kholia/PicoRX/PCB/Easy-uSDX-v4/README.txt

https://www.w0qe.com/Projects/rf_clipper_2016.html
