kholia/PicoRX/PCB/Easy-uSDX-v4/info/README.txt

https://www.james.ahlstrom.name/quisk/docs.html

https://github.com/pothosware/SoapyAudio (Gqrx supports IQ sound card input
using this)

https://github.com/kaefe64/Arduino_uSDX_Pico_FFT_Proj/issues/4

https://github.com/ArjanteMarvelde/uSDR-pico - Wait for Arjan to release v4!

Select filters so to keep a narrow BW (6 kHz maximum).

https://martein.home.xs4all.nl/pa3ake/hmode/img/IF_detector_assy.jpg

Sound Blaster PLAY! 3 USB - has stereo input!
