kholia/PicoRX/PCB/Easy-uSDX-v2/info/QMX+.pdf

QMX+ PCB Rev 1 Schematics

Note, component numbering indicates the page number of the schematics; e.g. all components numbered 1xx are on page 1 etc. R106, for example, is on schematics page 1.

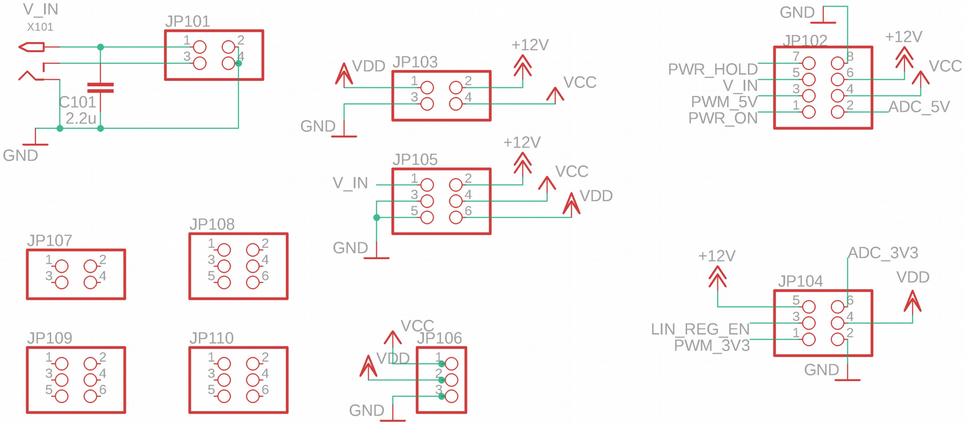
[picture p1: figure]

0: Connectors

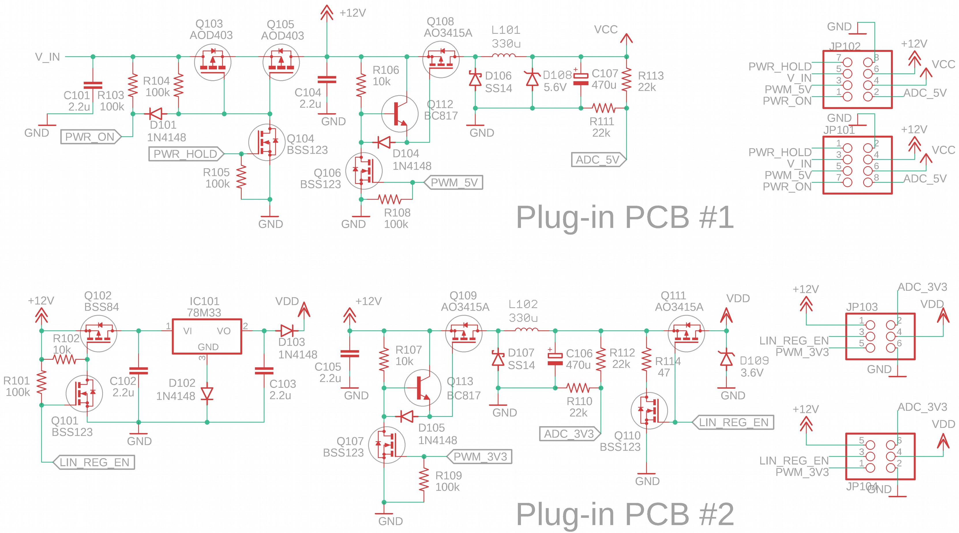
[picture p2: page 2]

1: SMS power supplies

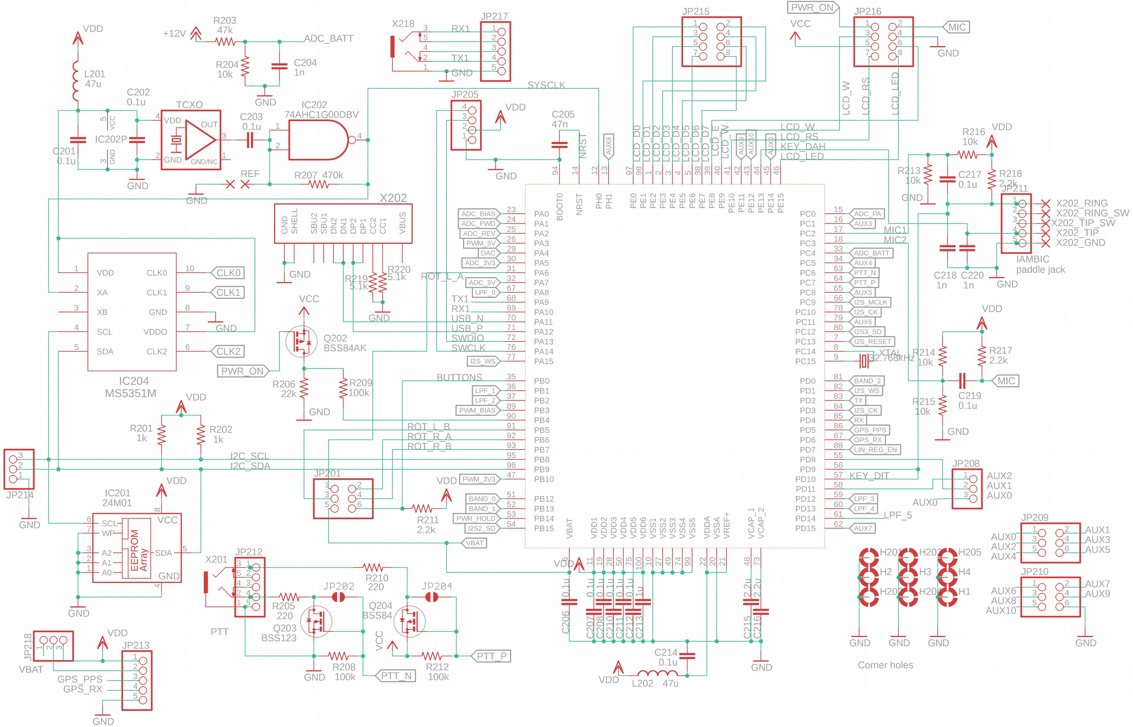
[picture p3: page 3]

2: Microcontroller and digital sections

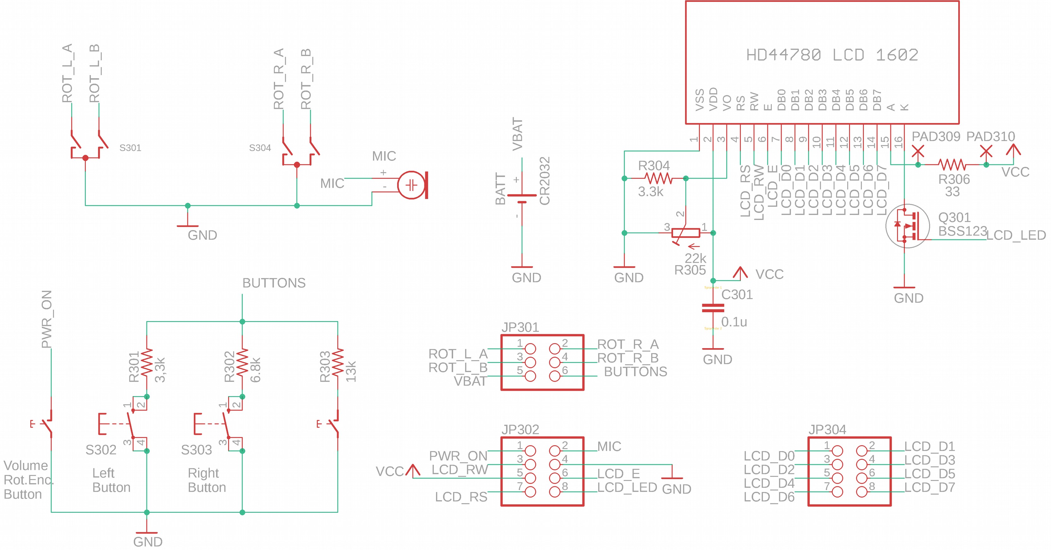
[picture p4: page 4]

3: Front panel board

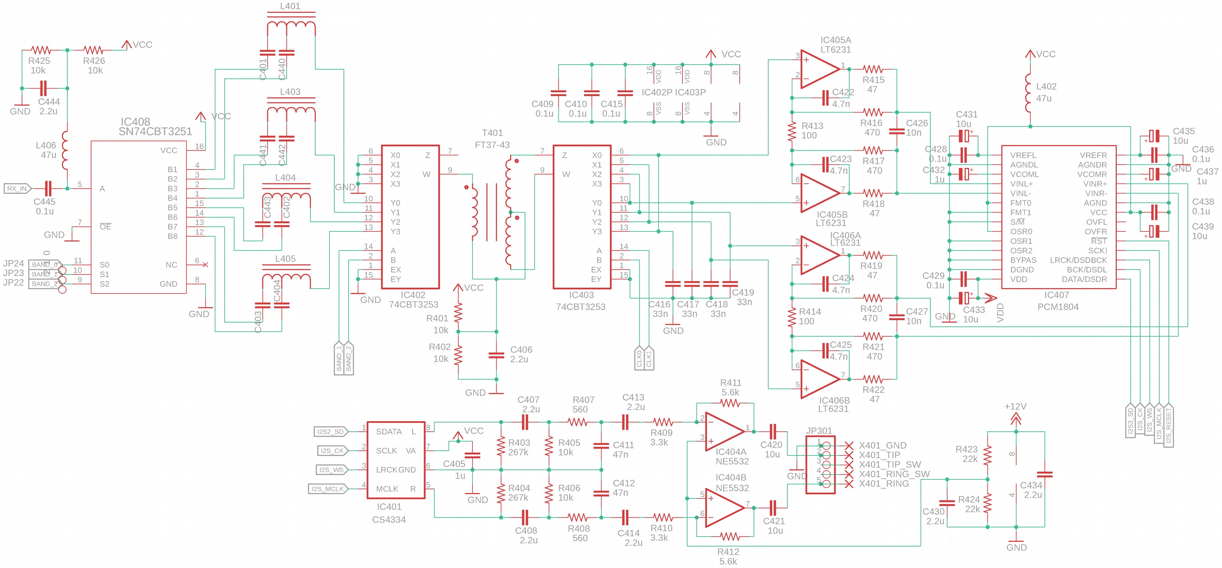
[picture p5: figure]

4: Receiver

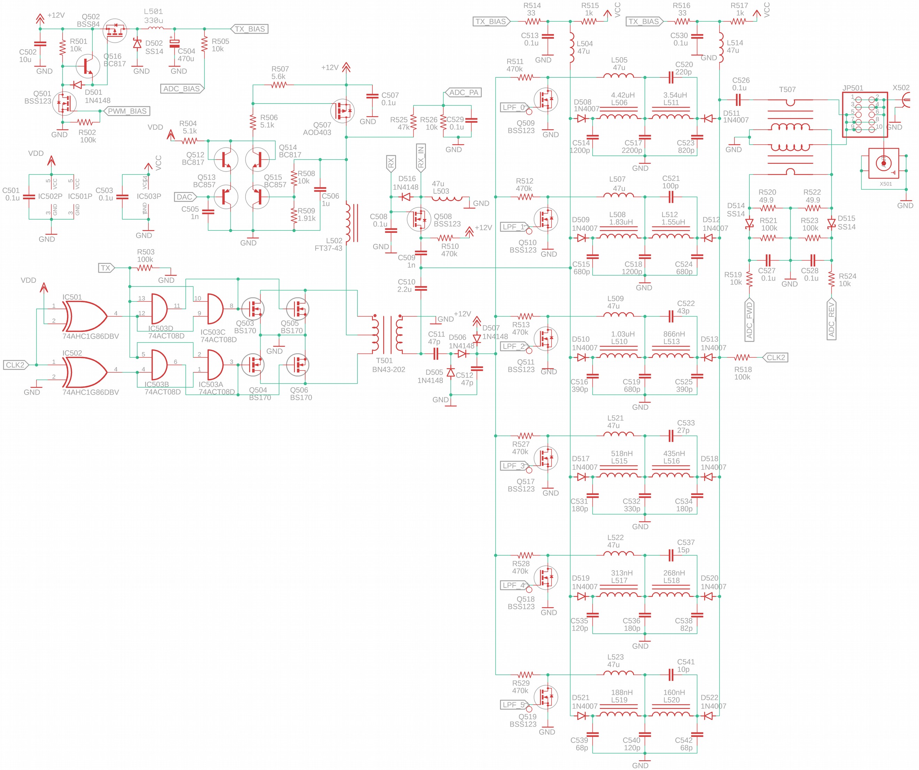
[picture p6: page 6]

5: Transmitter
