kholia/PicoRX/PCB/Easy-uSDX-v2/models/pj-307.step

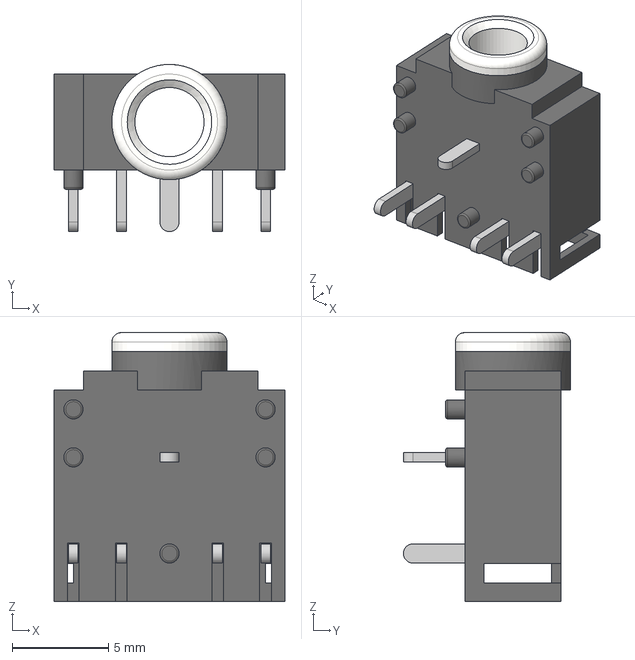
[picture p41: CAD file, 2024-11-27, an earlier design]
PCB/Easy-uSDX-v2/models/pj-307.step
12.0 x 8.70 x 14.0 mm
