kholia/PicoRX/PCB/Easy-uSDX-v4/models/Adafruit Si5351A.step

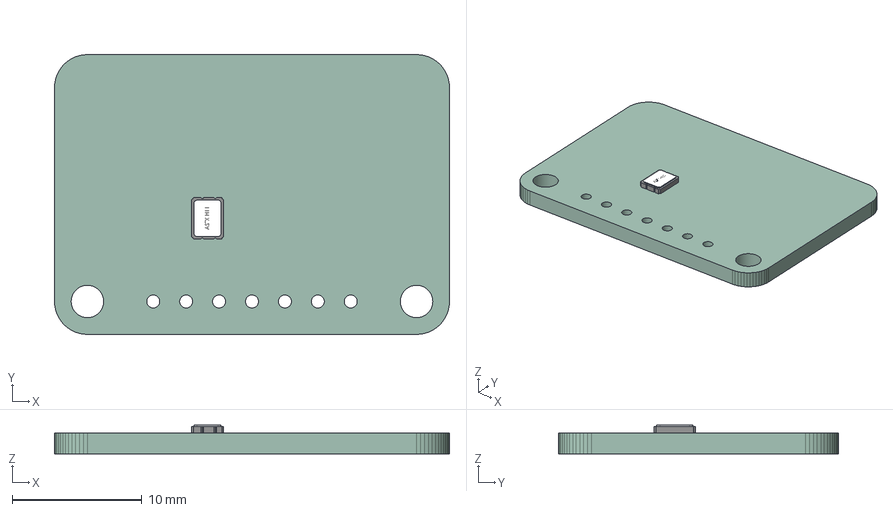
[picture p42: CAD file, 2024-11-27, an earlier design]
PCB/Easy-uSDX-v4/models/Adafruit Si5351A.step
30.5 x 21.6 x 2.20 mm
PCB
