kholia/PicoRX/PCB/Easy-uSDX-v2/models/CUI_DEVICES_SJ1-3523N.step

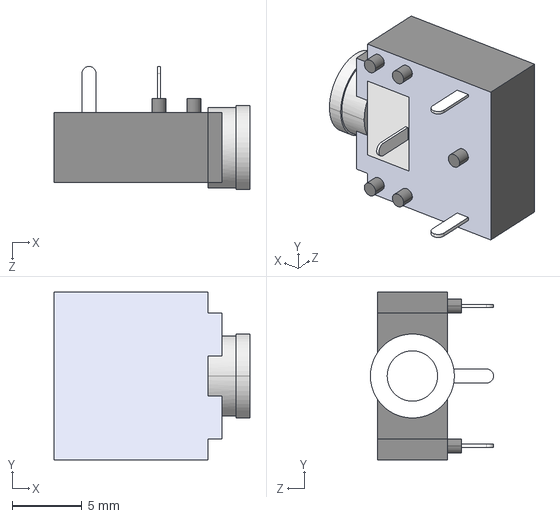
[picture p43: CAD file, 2024-11-27, an earlier design]
PCB/Easy-uSDX-v2/models/CUI_DEVICES_SJ1-3523N.step
14.0 x 12.0 x 8.80 mm
