kholia/PicoRX/PCB/Easy-uSDX-v3/models/SO-8_S_LIT.step

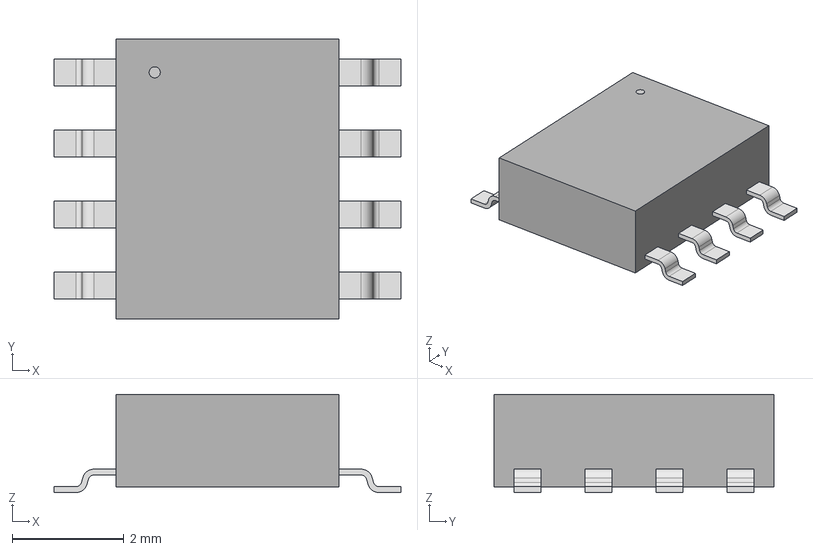
[picture p44: CAD file, 2024-11-27, an earlier design]
PCB/Easy-uSDX-v3/models/SO-8_S_LIT.step
6.20 x 5.00 x 1.75 mm
