kholia/PicoRX/PCB/Easy-uSDX-v4/models/22-23-2021.stp

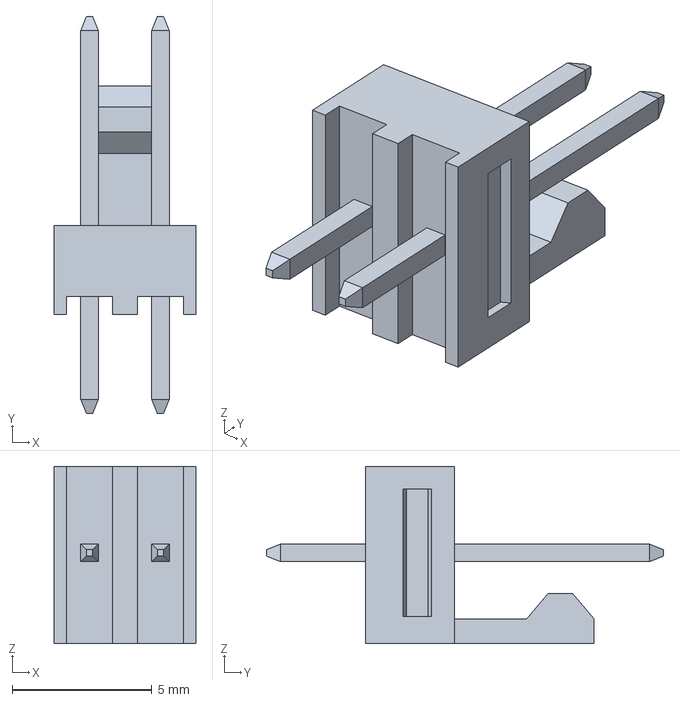
[picture p45: CAD file, 2024-11-27, an earlier design]
PCB/Easy-uSDX-v4/models/22-23-2021.stp
5.08 x 14.2 x 6.35 mm
