kholia/PicoRX/PCB/Easy-uSDX-v3/models/smd1812.stp

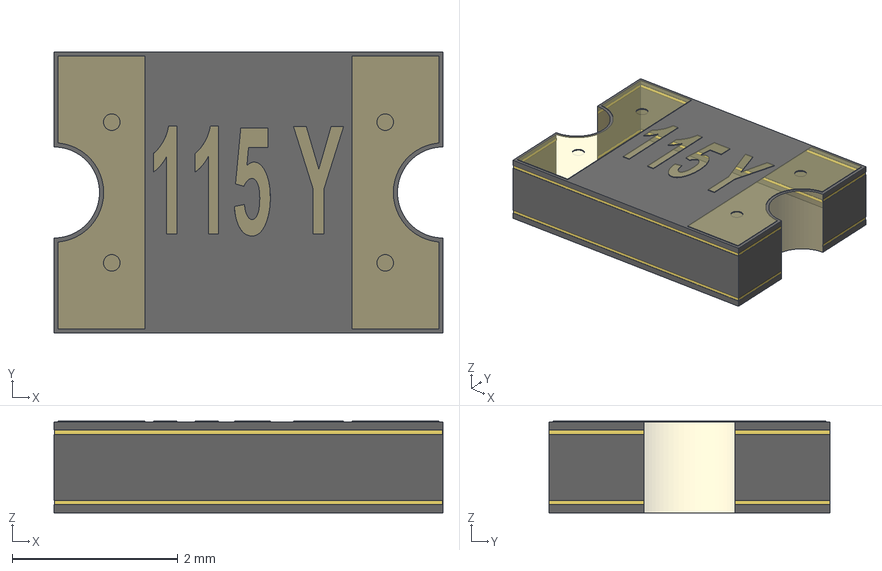
[picture p46: CAD file, 2024-11-27, an earlier design]
PCB/Easy-uSDX-v3/models/smd1812.stp
4.70 x 3.40 x 1.11 mm
