kholia/PicoRX/PCB/Easy-uSDX-v2/models/901-144.stp

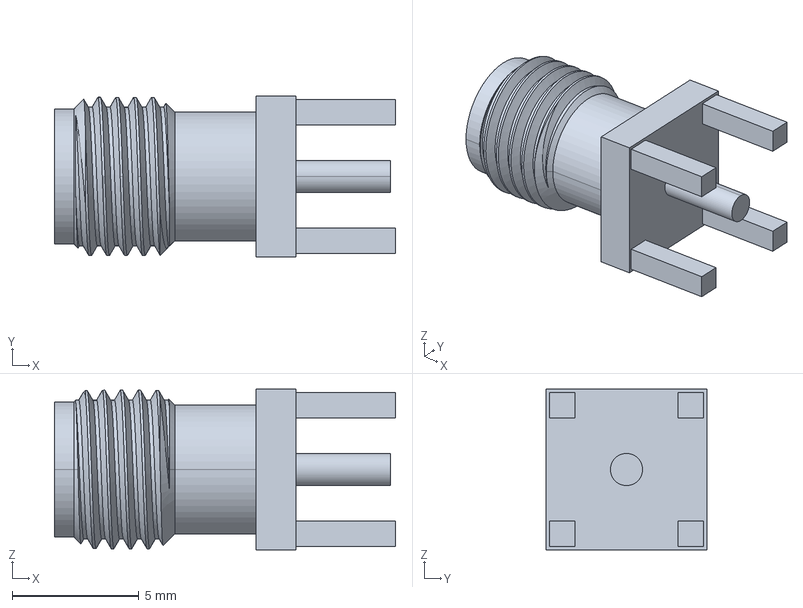
[picture p47: CAD file, 2024-11-27, an earlier design]
PCB/Easy-uSDX-v2/models/901-144.stp
13.5 x 6.35 x 6.35 mm
