kholia/PicoRX/(list of files, cad)

Other CAD files:
PCB/Easy-uSDX-v3/models/Adafruit Si5351A Plain.step
PCB/Easy-uSDX-v2/models/Adafruit Si5351A Plain.step
PCB/Easy-uSDX-v4/models/Adafruit Si5351A Plain.step
