kholia/PicoRX/PCB/Easy-uSDX-v2/SDR-Board.pdf

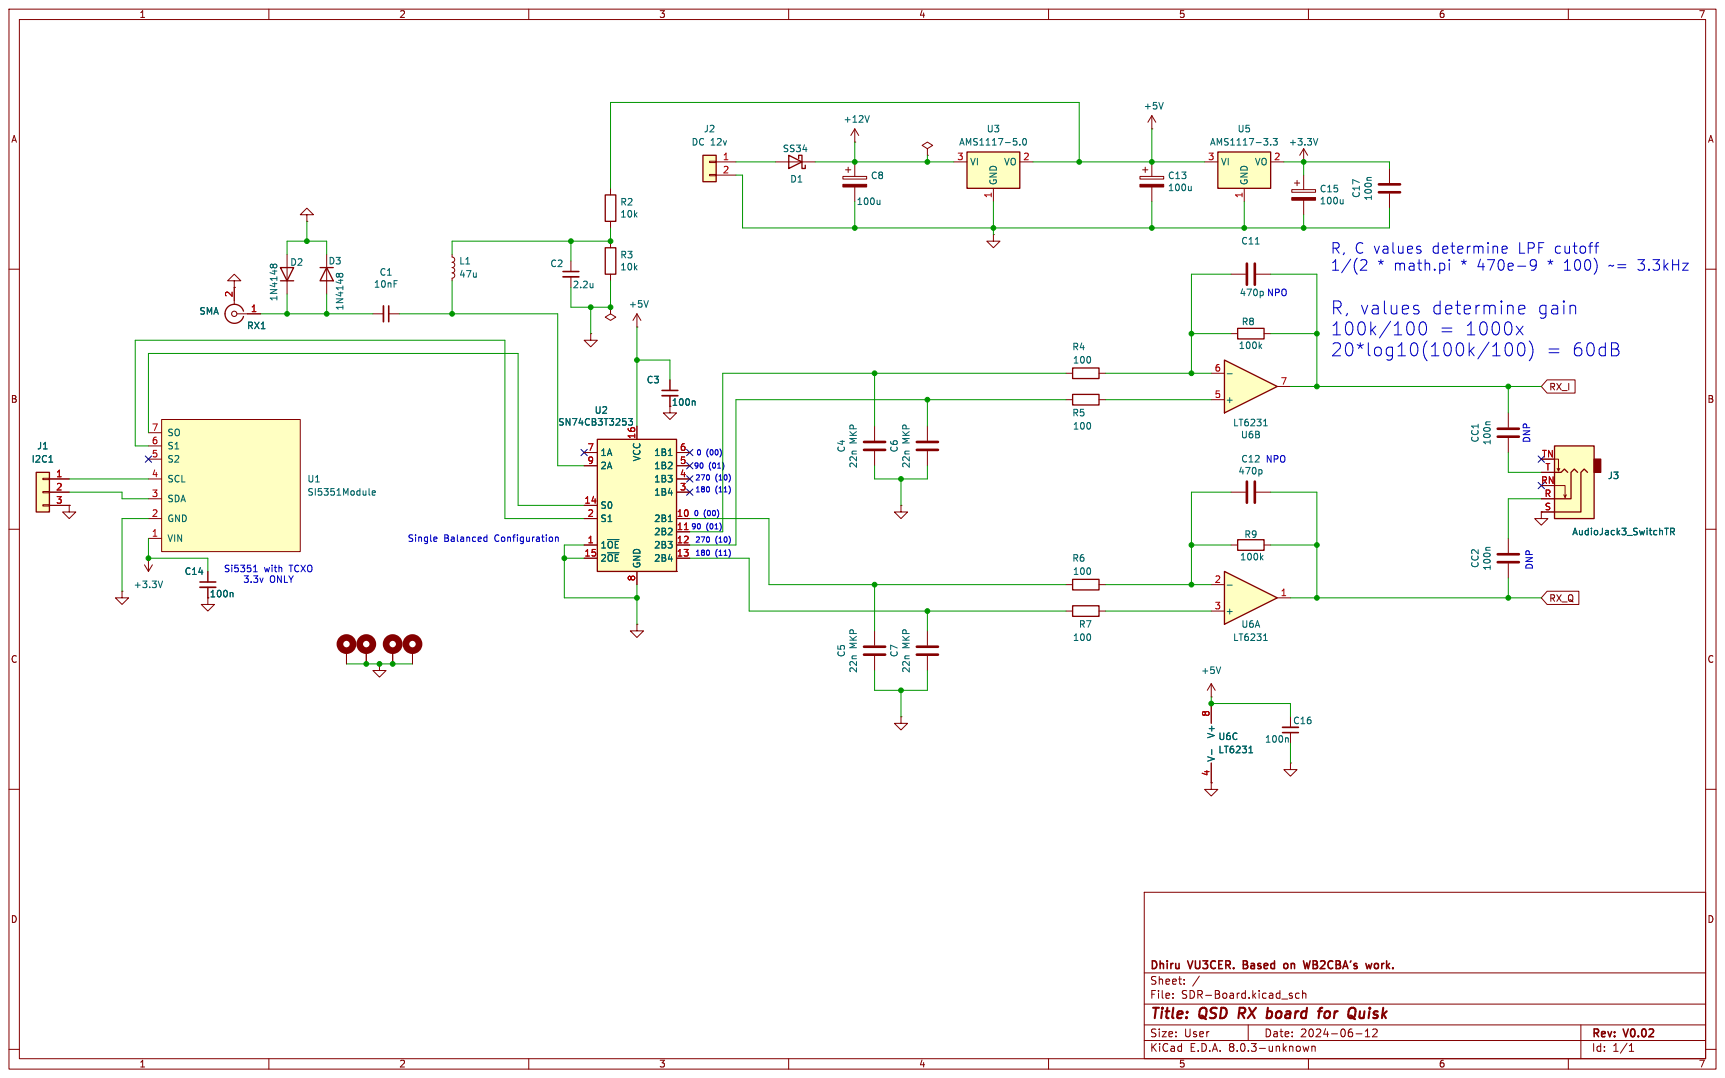
[picture p48: page 1]

Id: 1/1 Title: QSD RX board for Quisk
