kholia/PicoRX/PCB/Easy-uSDX-v3/SDR-Board.pdf

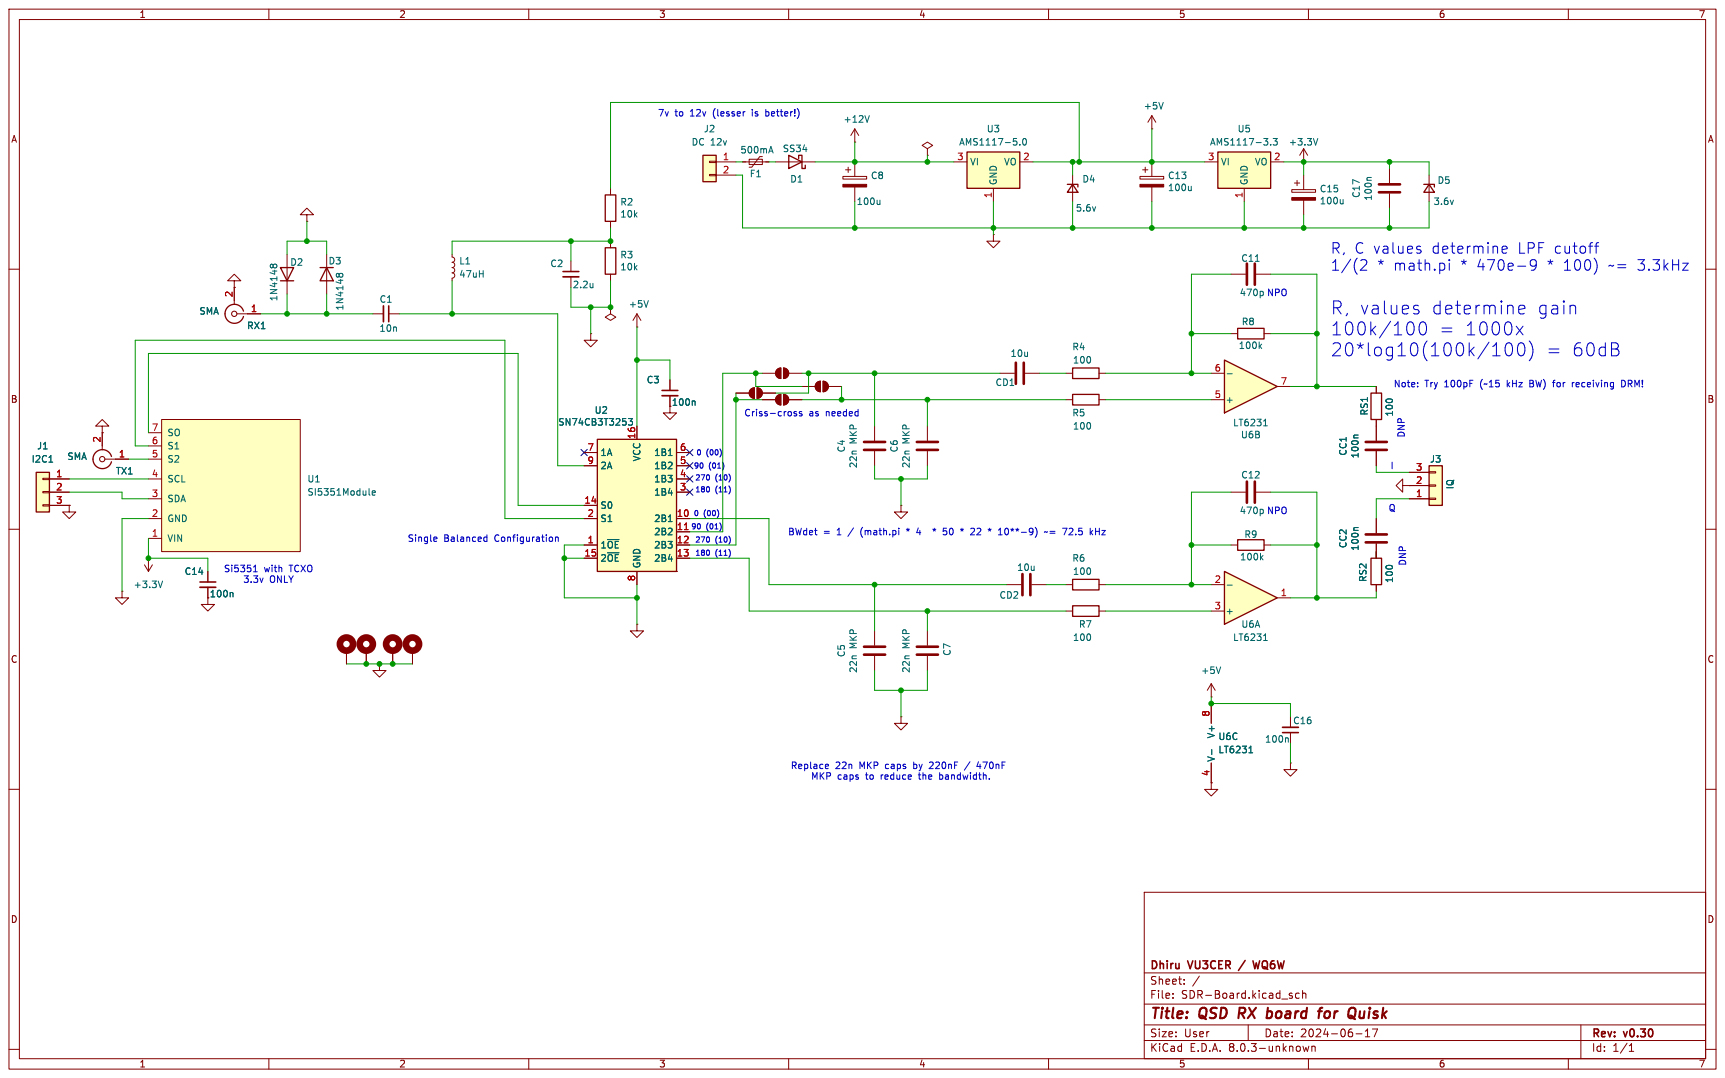
[picture p49: page 1]

Replace 22n MKP caps by 220nF / 470nF MKP caps to reduce the bandwidth. 0 (00) 270 (10) 180 (11) C3

File: SDR-Board.kicad_sch Sheet: / Dhiru VU3CER / WQ6W

Id: 1/1 Title: QSD RX board for Quisk
