kholia/PicoRX/PCB/Easy-uSDX-v3/info/truSDX_Main_1_2.pdf

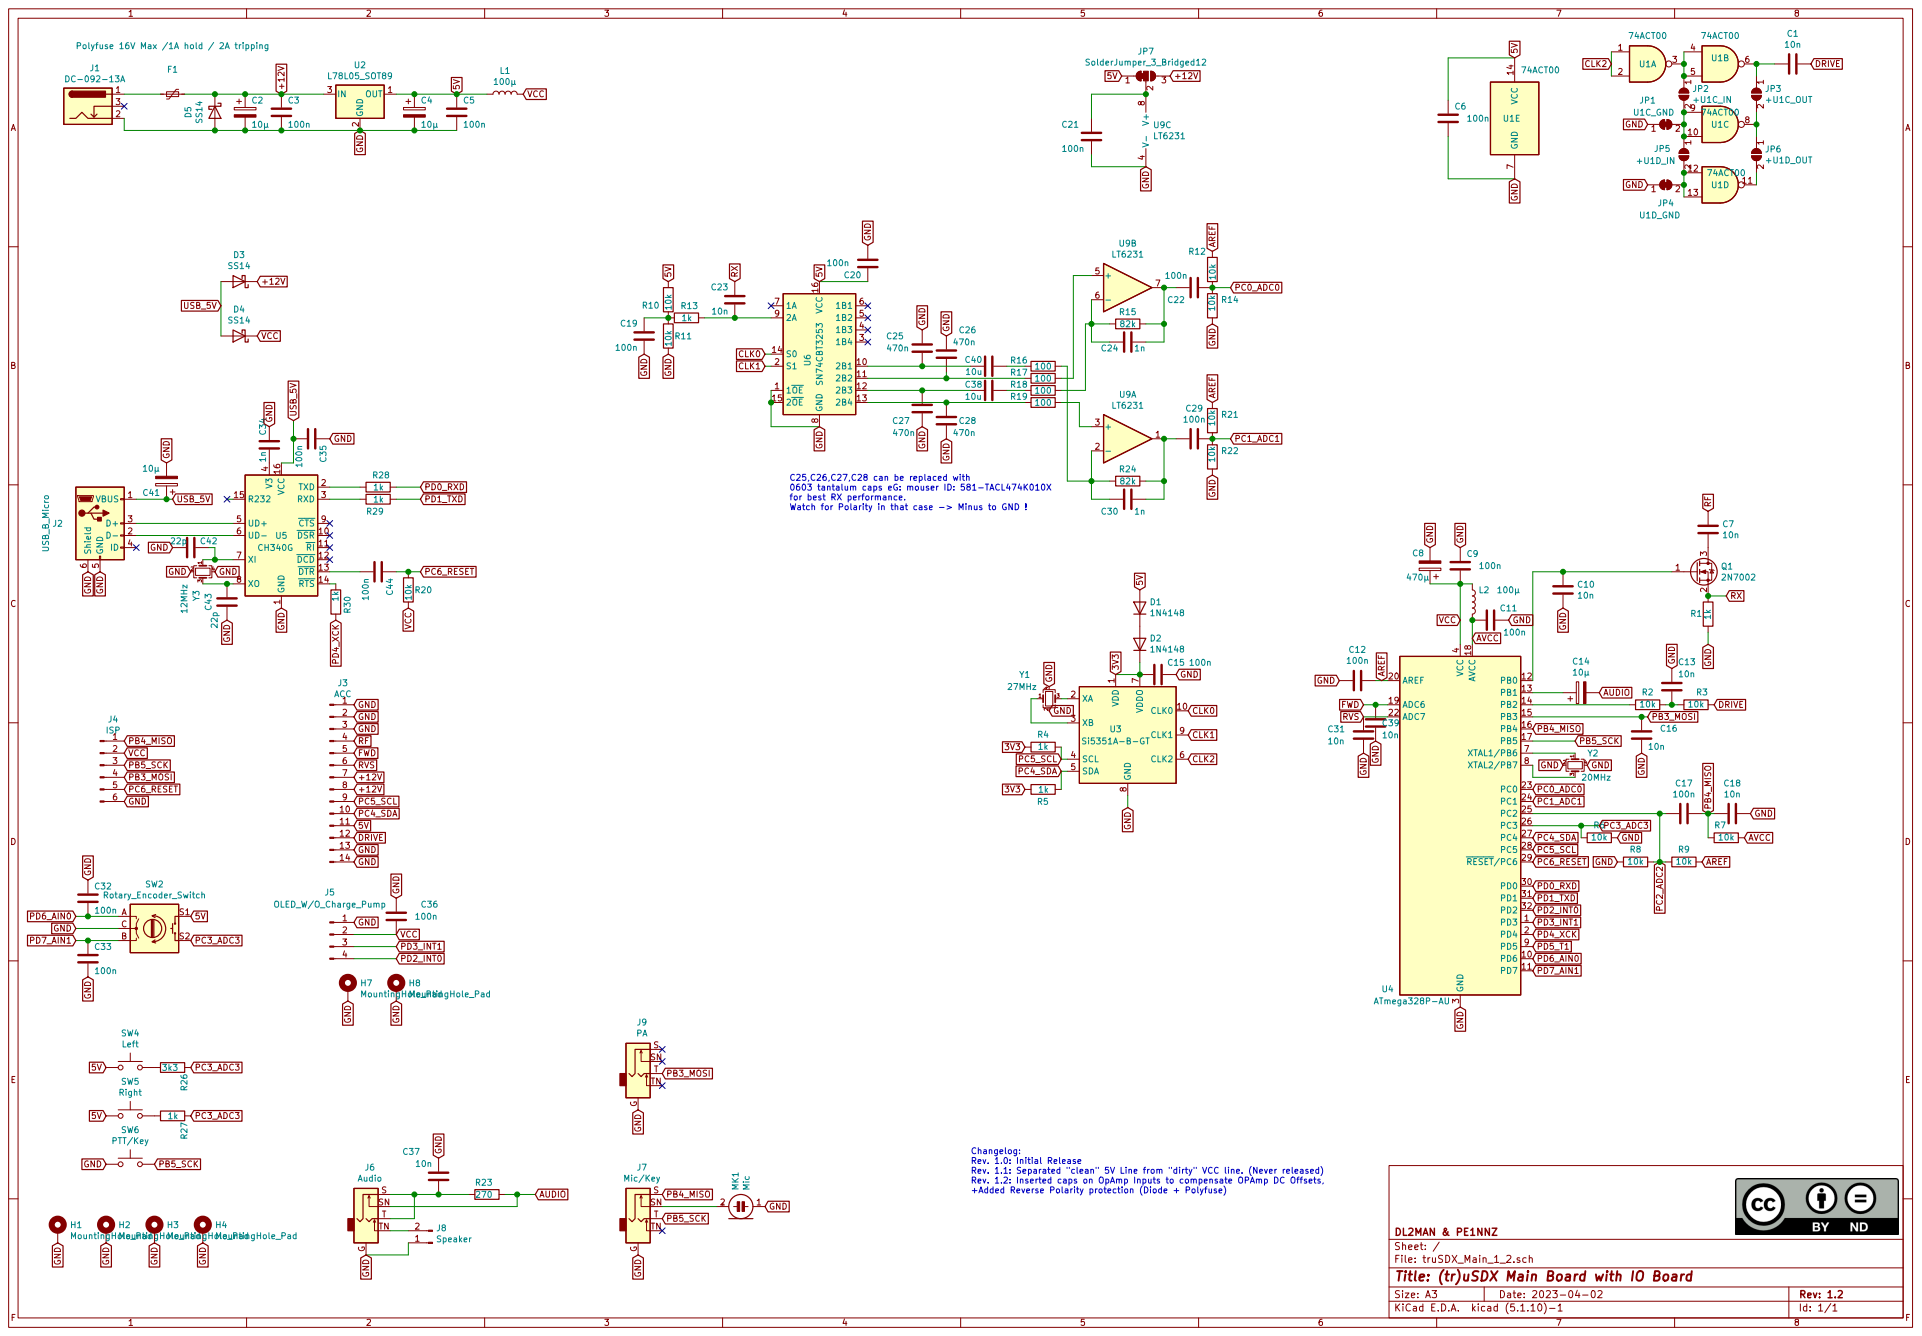
[picture p56: page 1]

1 DSR 10 RI 11 DCD 12 DTR 13 RTS 14 R232 15 VCC 16 TXD 2 RXD 3 V3

4 UD+ 5 UD- 6 XI 7 XO 8 CTS 9 U5 CH340G

PB3_MOSI C25,C26,C27,C28 can be replaced with
0603 tantalum caps eG: mouser ID: 581-TACL474K010X
for best RX performance.
Watch for Polarity in that case -> Minus to GND !

1 CLK0 10 XA 2 XB 3 SCL 4 SDA 5 CLK2 6 VDDO

Changelog: Rev. 1.0: Initial Release Rev. 1.1: Separated "clean" 5V Line from "dirty" VCC line. (Never released)

Rev. 1.2: Inserted caps on OpAmp Inputs to compensate OPAmp DC Offsets,
+Added Reverse Polarity protection (Diode + Polyfuse)

Id: 1/1 Title: (tr)uSDX Main Board with IO Board
