kholia/PicoRX/PCB/Easy-uSDX-v3/info/10nF100V (0.01uF -103) - Polyester Box Capacitor.pdf

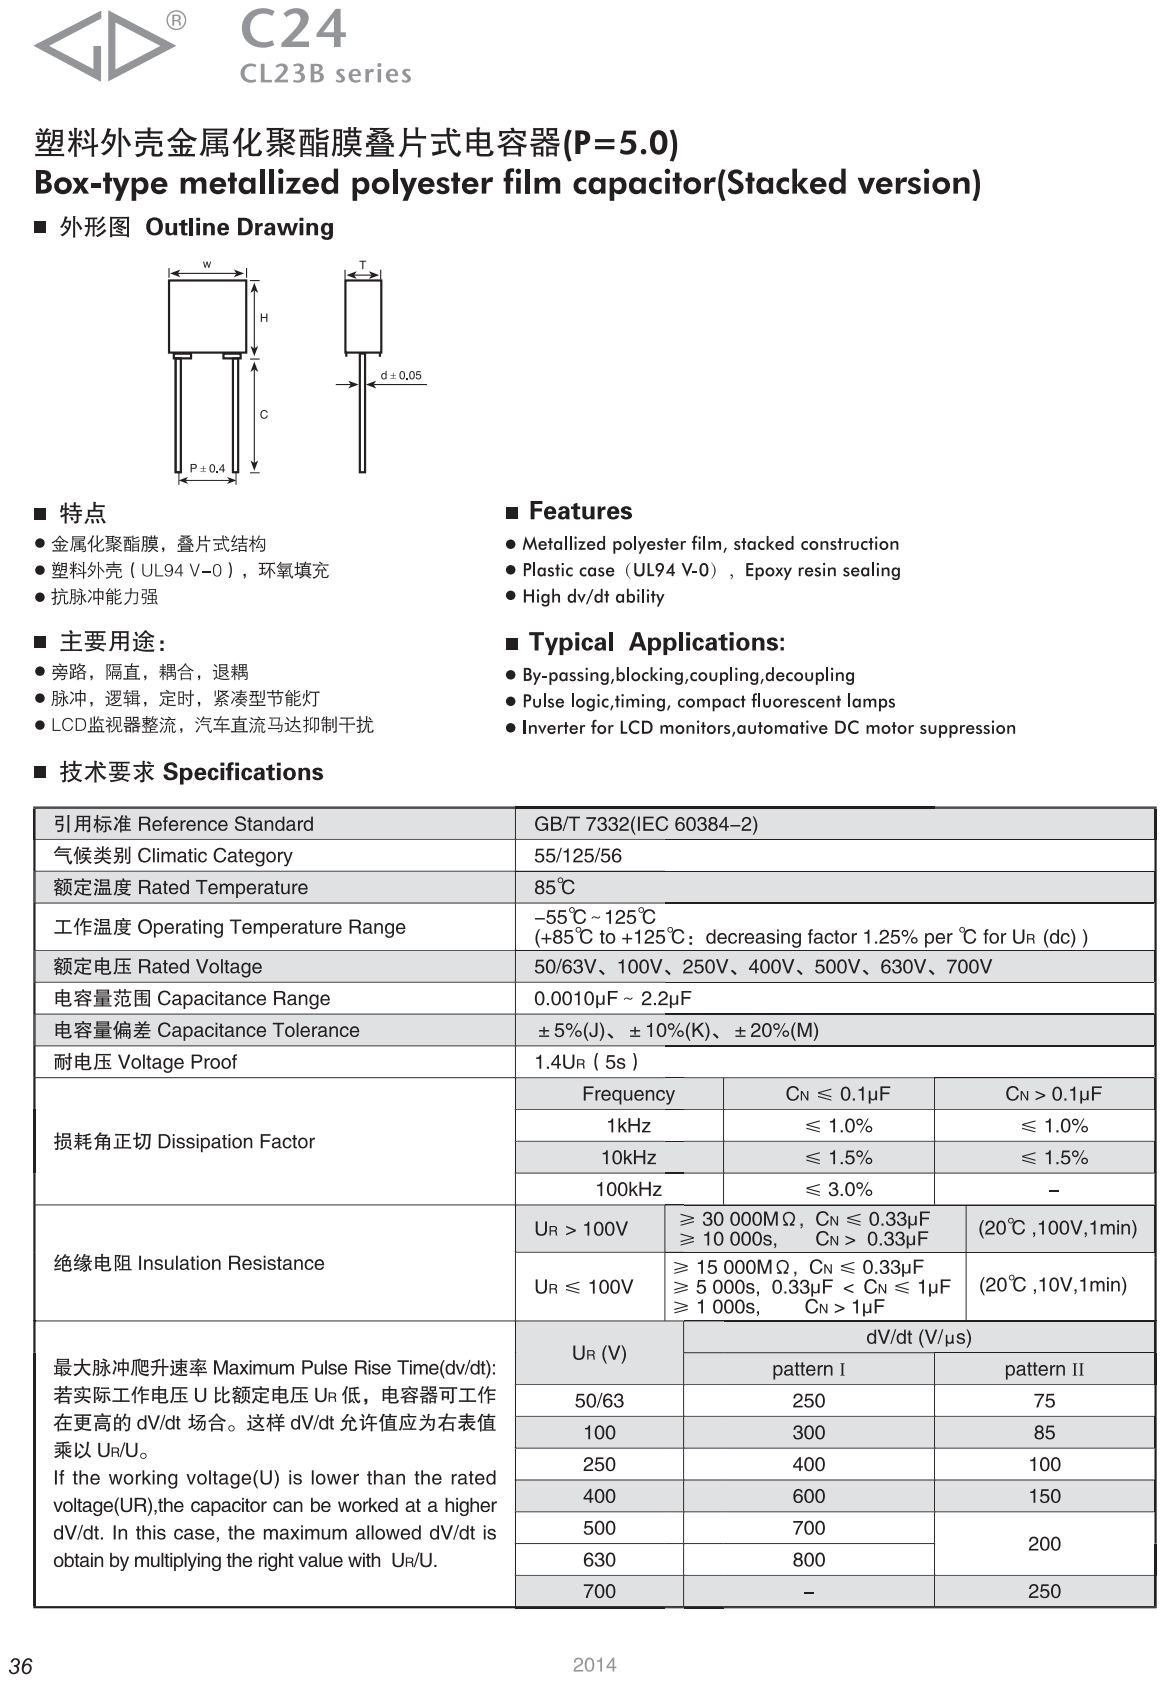
[picture p57: page 1]

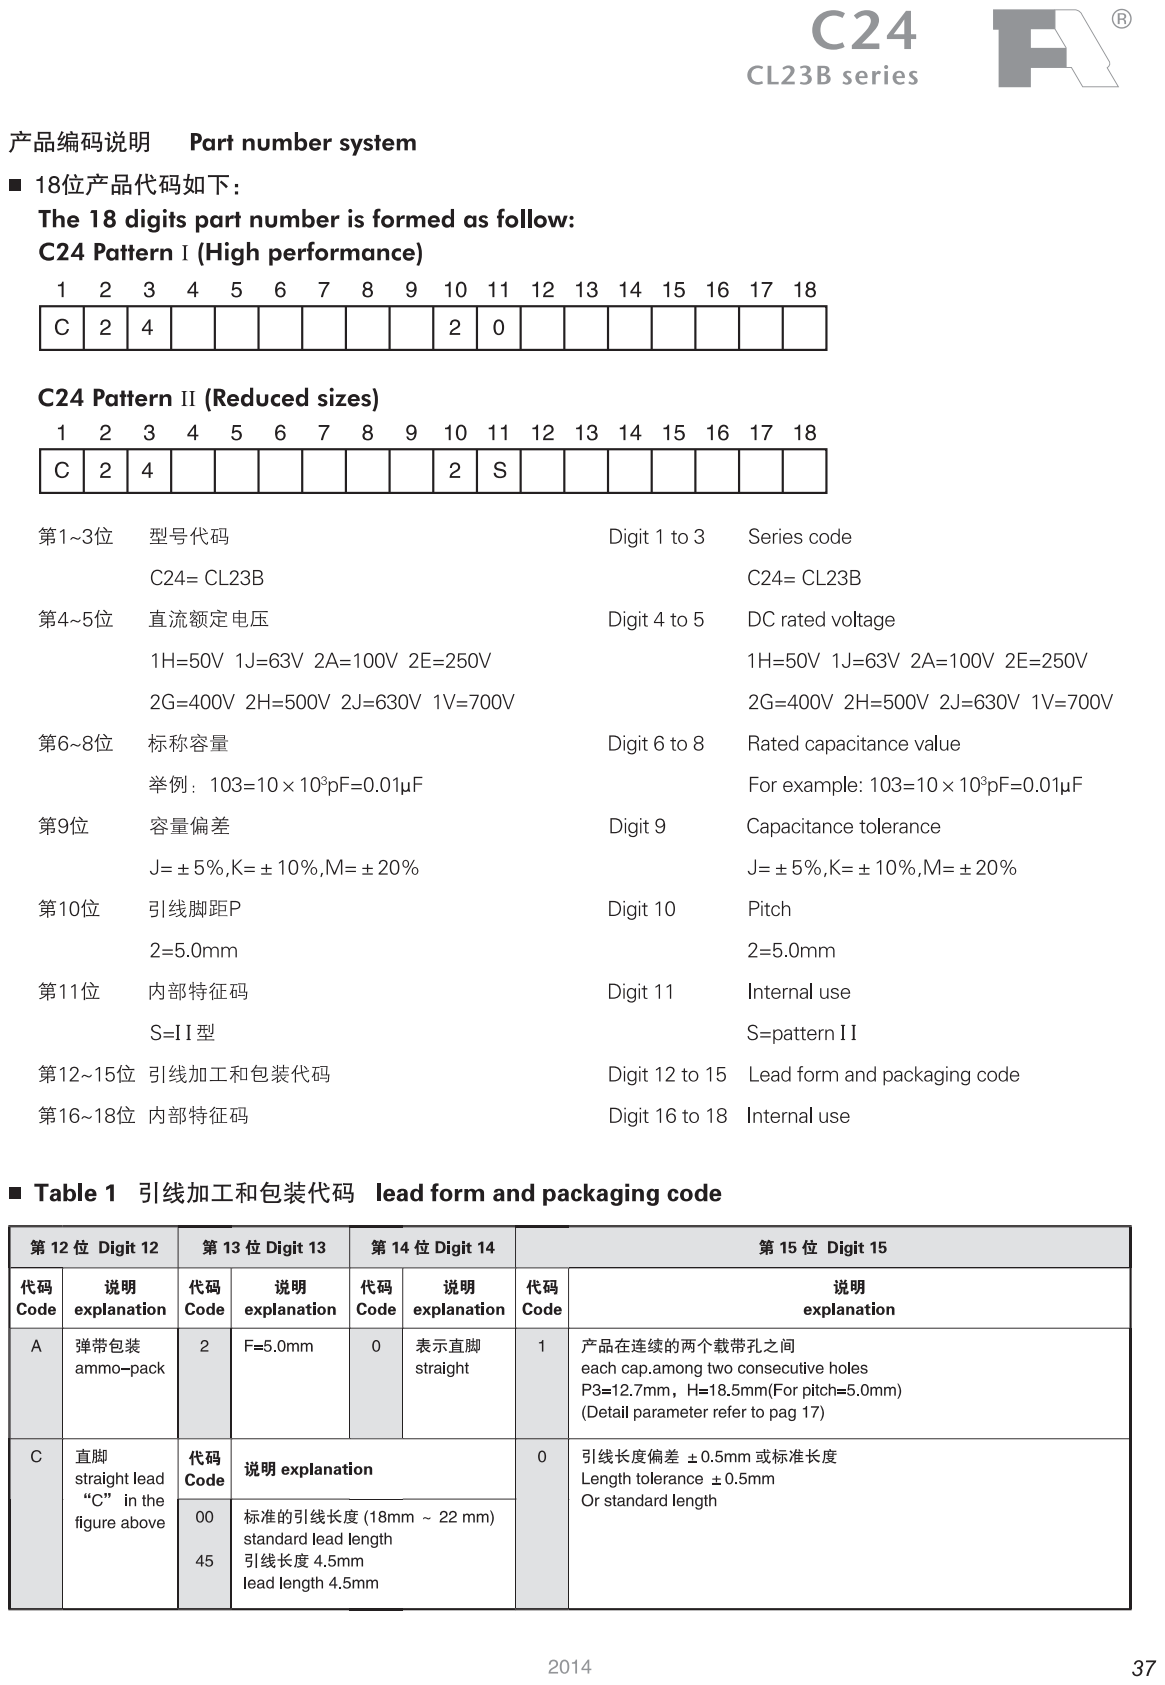
[picture p58: page 2]

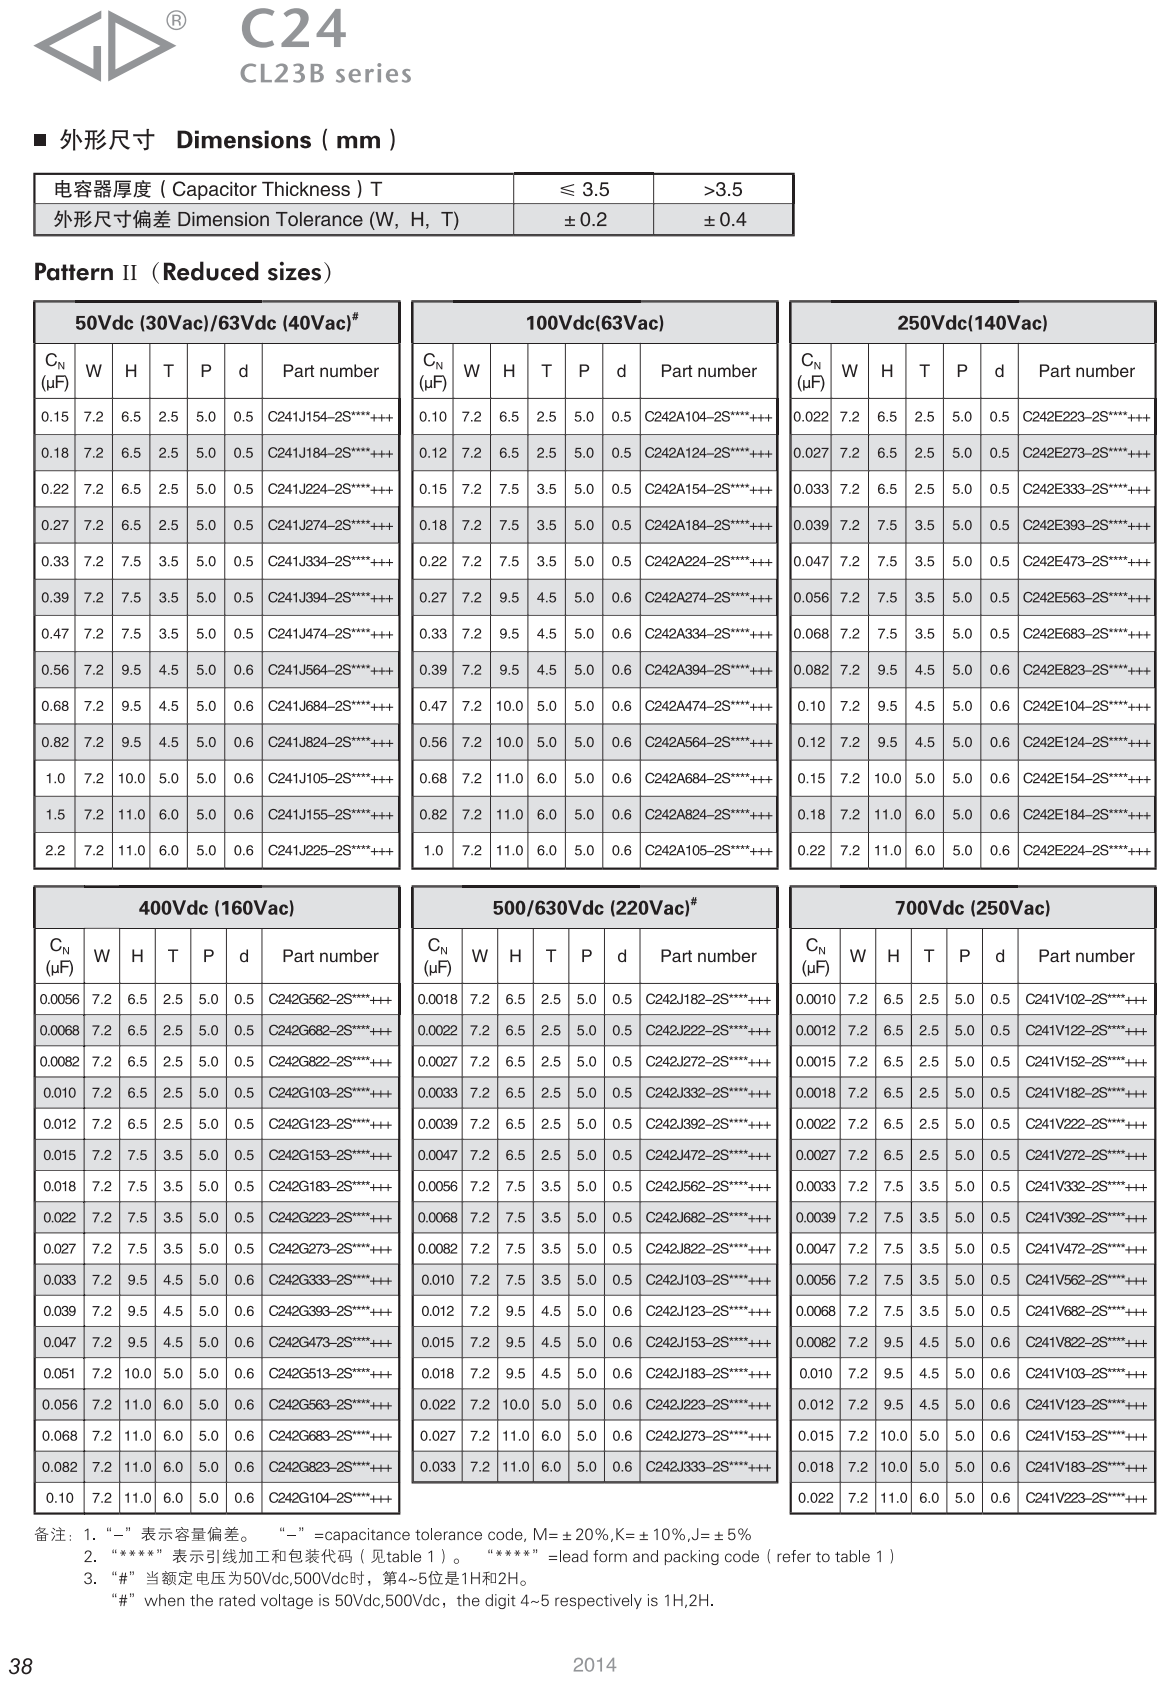
[picture p59: page 3]

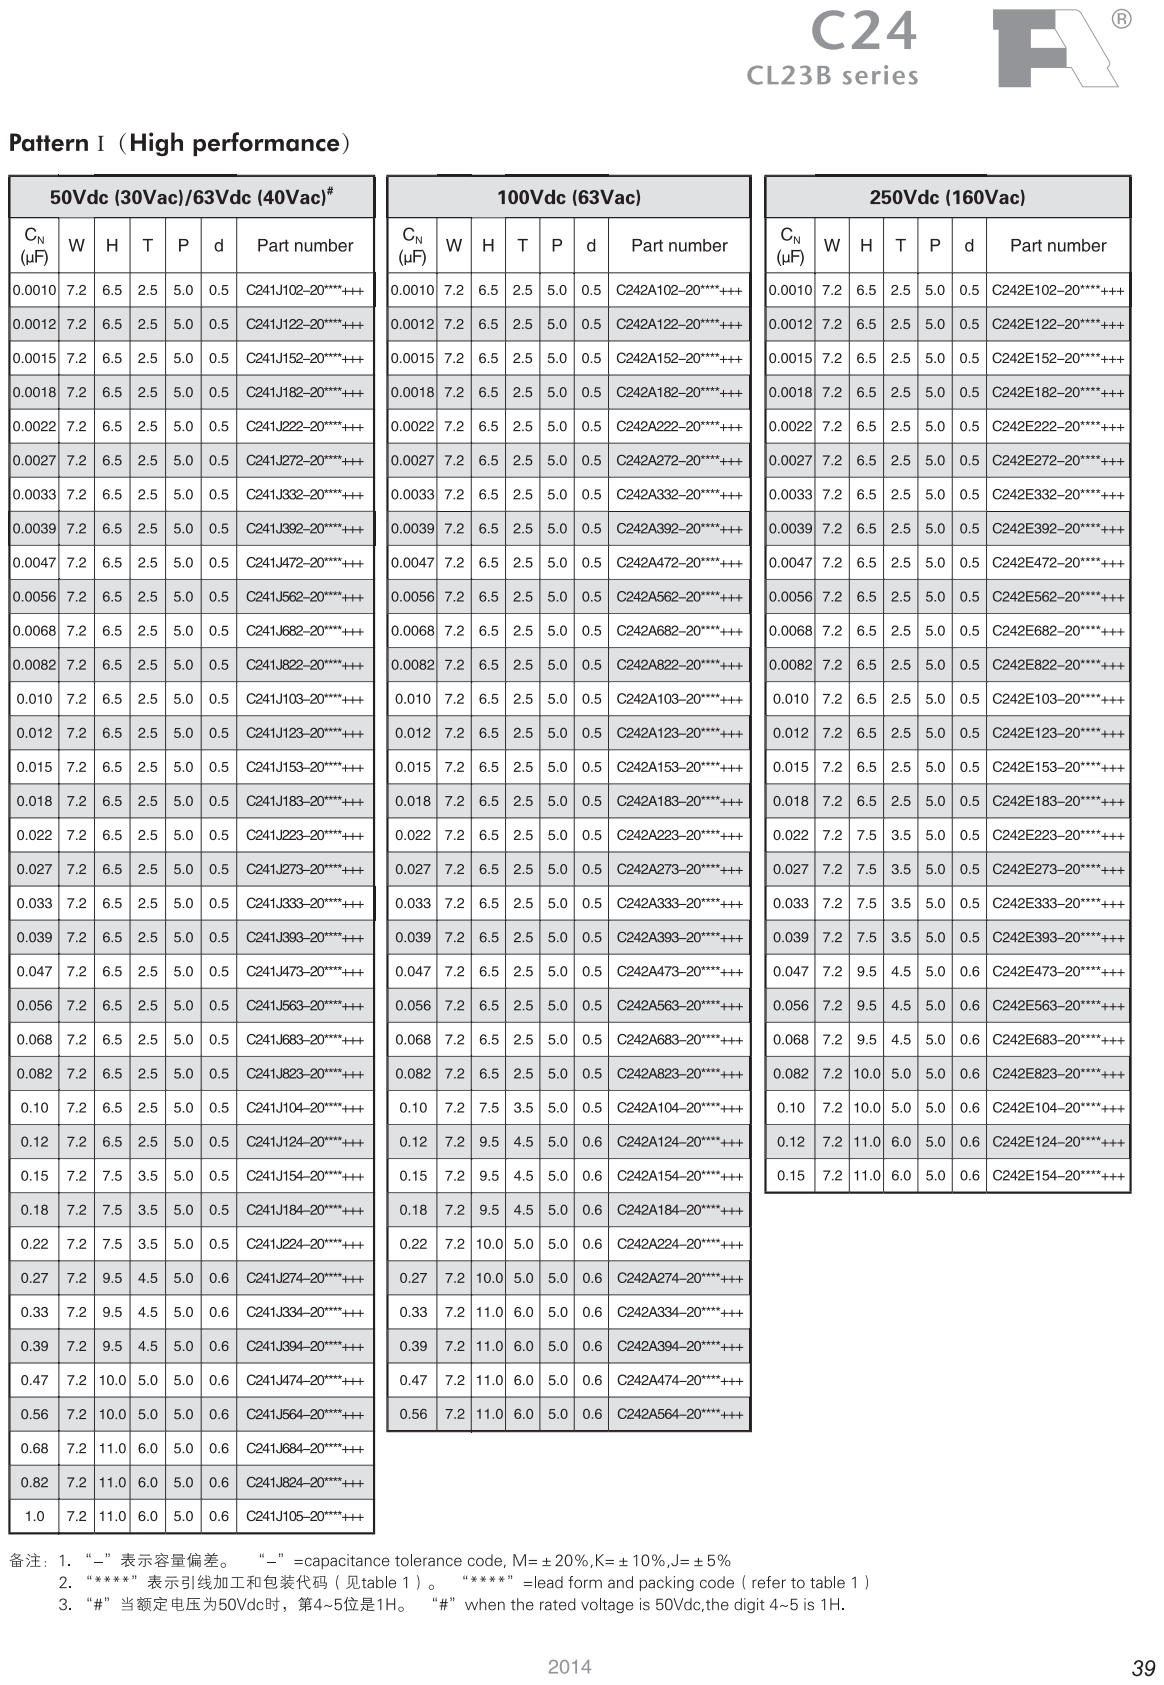
[picture p60: page 4]

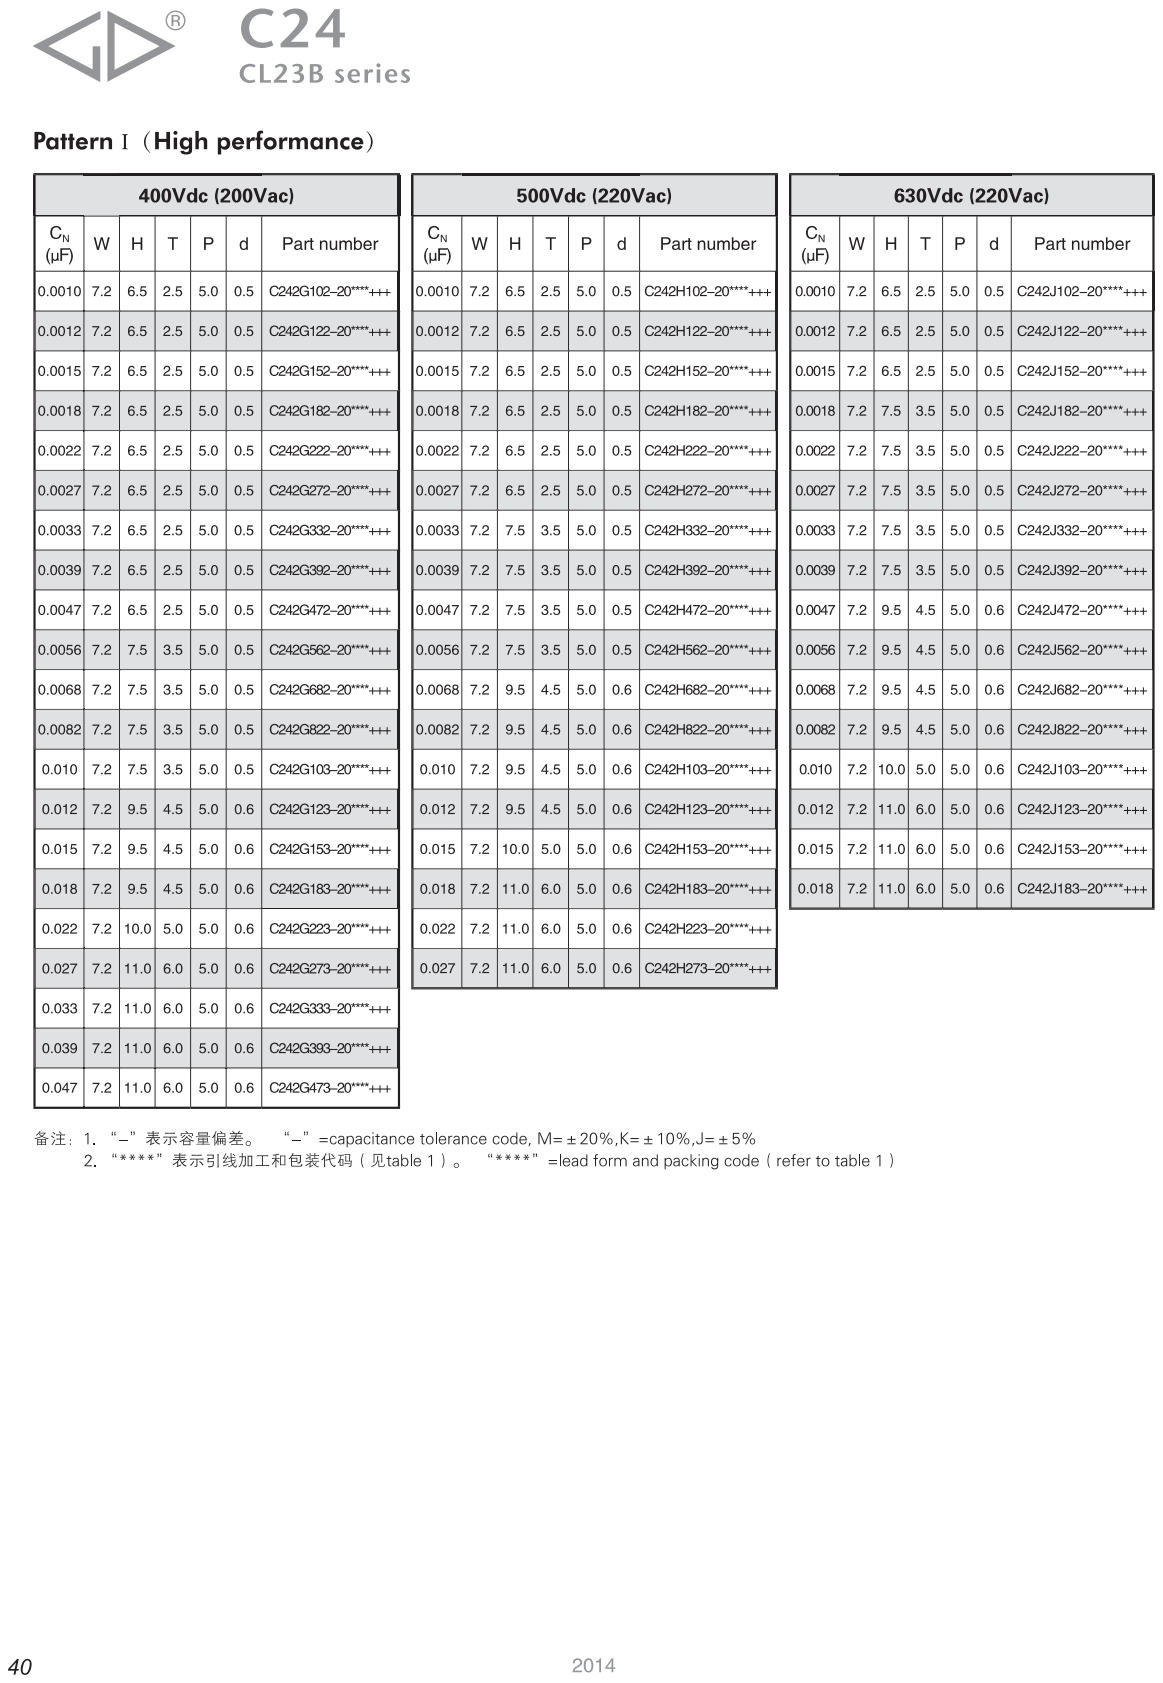
[picture p61: page 5]
