kholia/PicoRX/PCB/Easy-uSDX-v3/info/pico_rx-Quadrature Sampling Detector.pdf

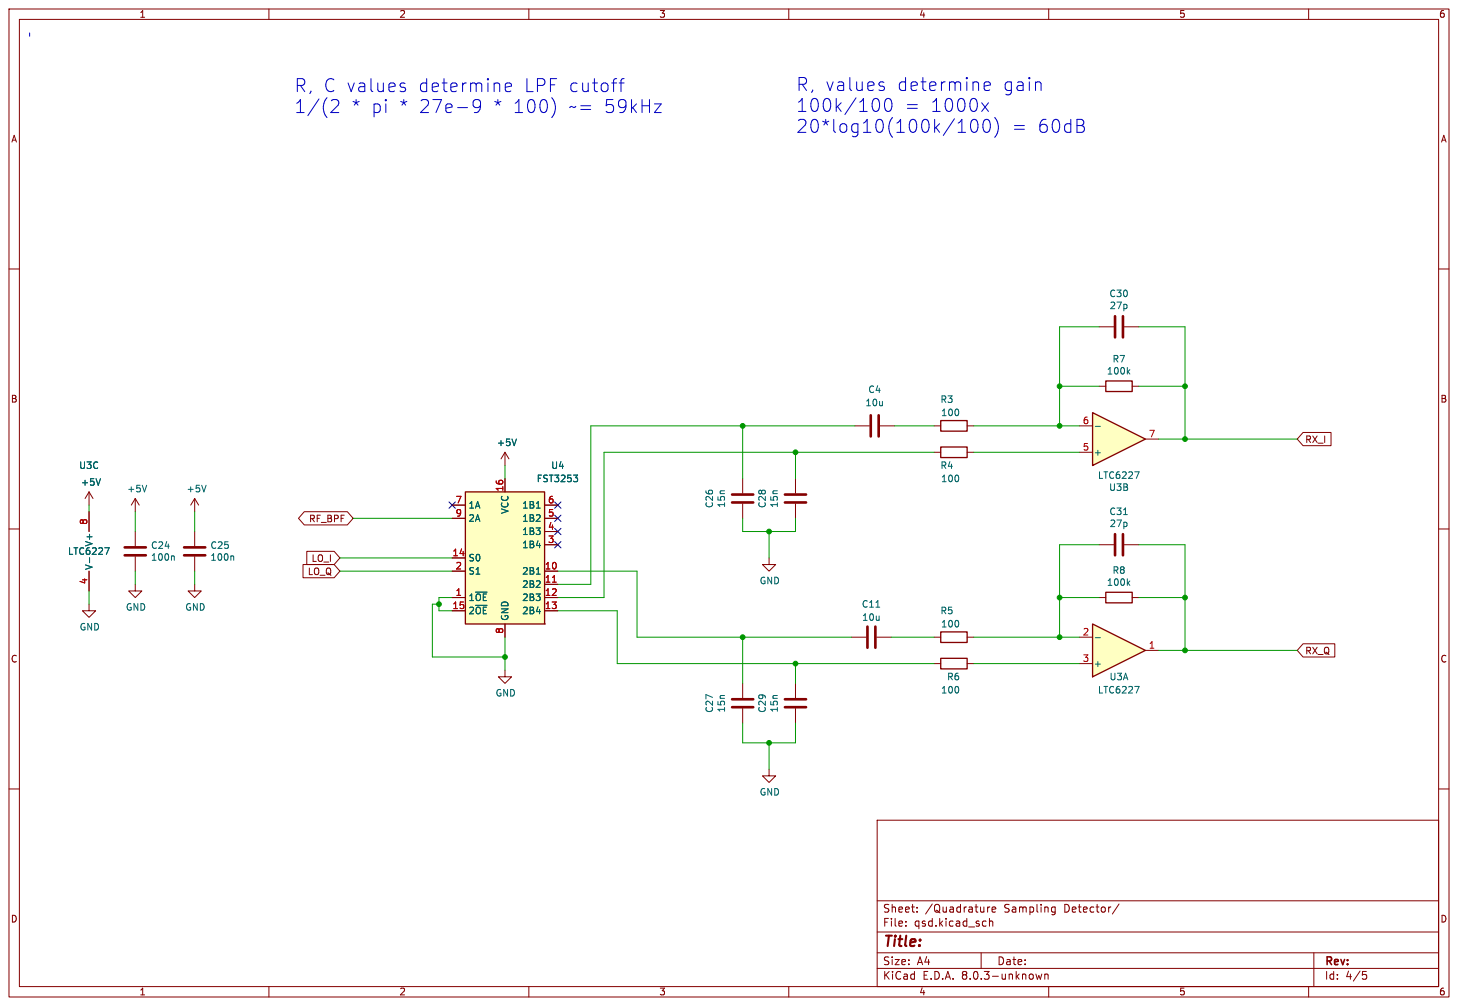
[picture p62: page 1]

R, C values determine LPF cutoff
