kholia/PicoRX/PCB/Easy-uSDX-v4/SDR-Board.kicad_pcb

## KiCad design PCB/Easy-uSDX-v4/SDR-Board.kicad_pcb (2024-11-27, an earlier design)

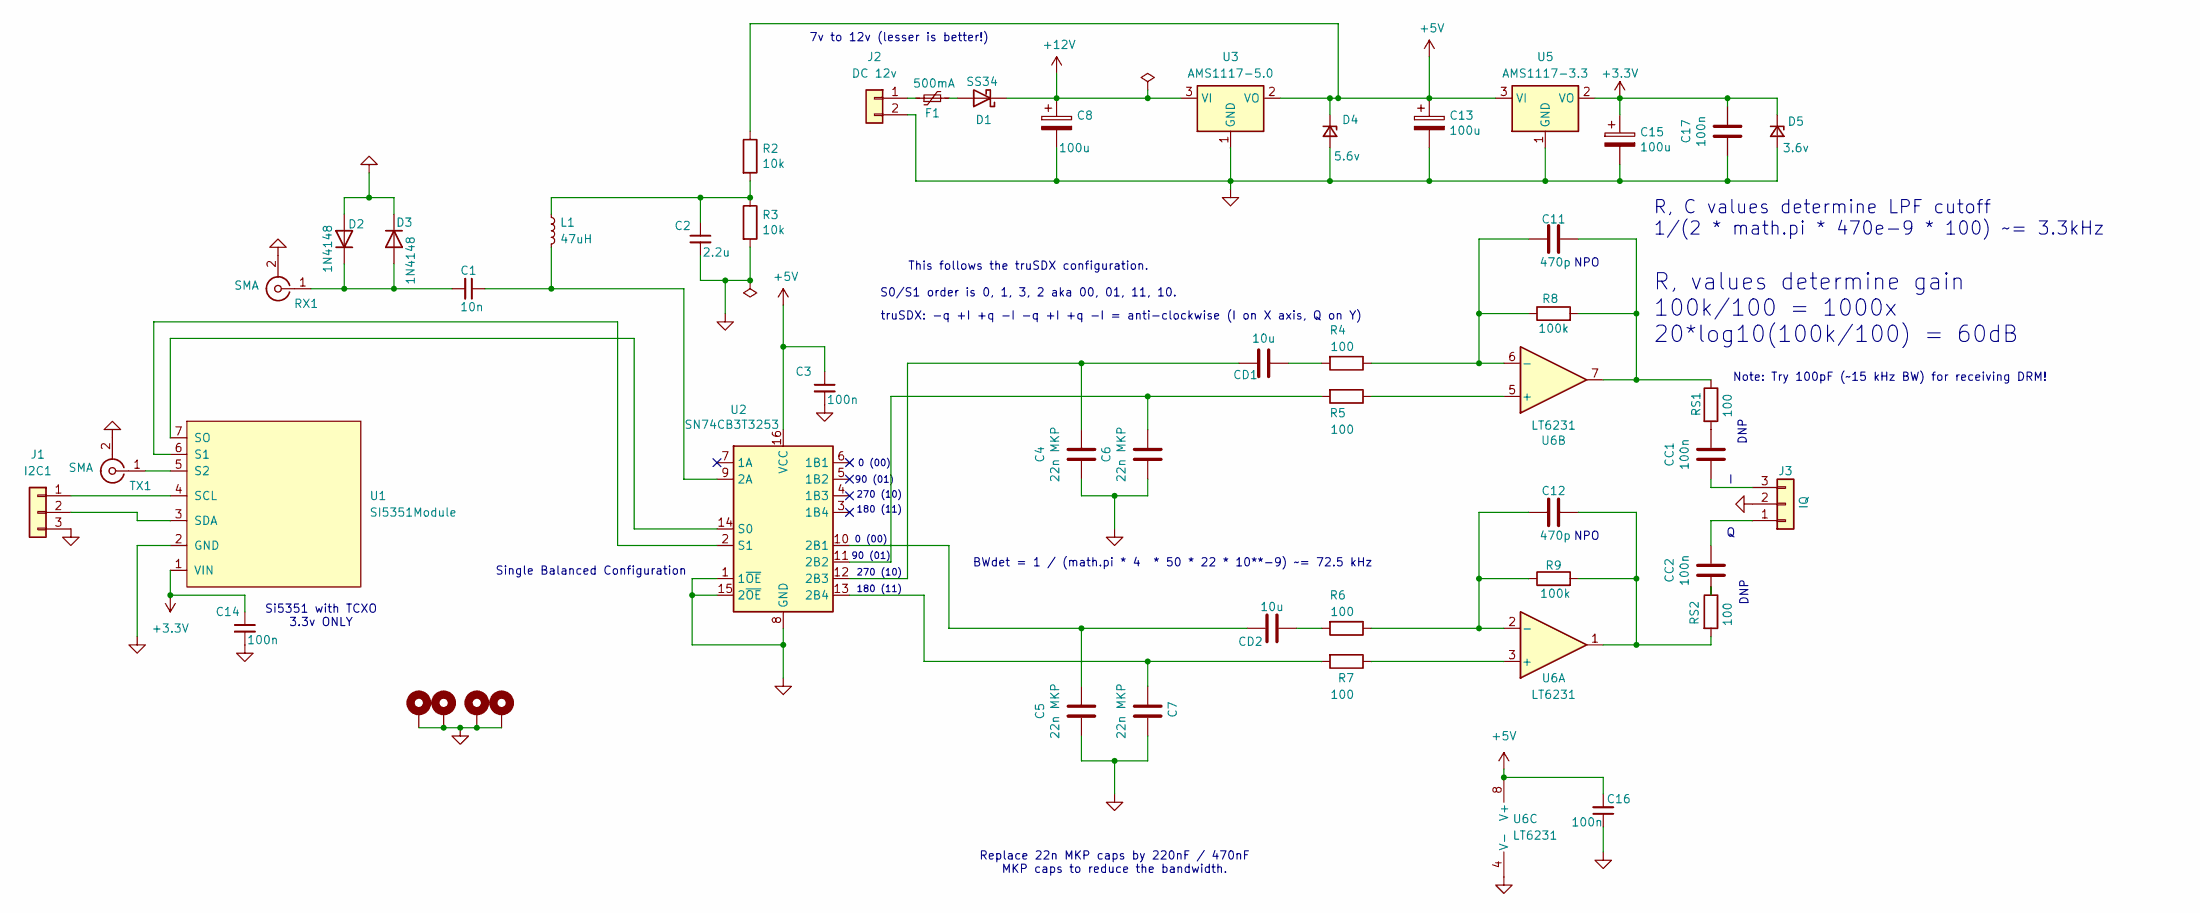
[picture p63: schematic SDR-Board.kicad_sch, QSD RX board for Quisk]

Parts:
C1: 10n; C_1206_3216Metric_Pad1.33x1.80mm_HandSolder
C2: 2.2u; C_1206_3216Metric_Pad1.33x1.80mm_HandSolder
C3, C14, C16, C17: 100n; C_1206_3216Metric_Pad1.33x1.80mm_HandSolder
C4, C5, C6, C7: 22n MKP; C_Rect_L7.0mm_W2.0mm_P5.00mm
C8, C13, C15: 100u; CP_Radial_D5.0mm_P2.50mm
C11, C12: 470p; C_1206_3216Metric_Pad1.33x1.80mm_HandSolder
CC1, CC2: 100n; C_1206_3216Metric_Pad1.33x1.80mm_HandSolder
CD1, CD2: 10u; C_1206_3216Metric_Pad1.33x1.80mm_HandSolder
D1: SS34; D_SMA_Handsoldering
D2, D3: 1N4148; D_DO-35_SOD27_P2.54mm_Vertical_KathodeUp
D4: 5.6v; D_SMA
D5: 3.6v; D_SOD-123
F1: 500mA; Fuse_1812_4532Metric_Pad1.30x3.40mm_HandSolder
H1, H2, H3, H4: MountingHole_Pad; MountingHole_3.2mm_M3_Pad_Via
J1: I2C1; PinHeader_1x03_P2.54mm_Vertical
J2: DC 12v; PinHeader_1x02_P2.54mm_Vertical
J3: IQ; PinSocket_1x03_P2.54mm_Vertical
L1: 47uH; L_1210_3225Metric_Pad1.42x2.65mm_HandSolder
R2, R3: 10k; R_1206_3216Metric_Pad1.30x1.75mm_HandSolder
R4, R5, R6, R7: 100; R_1206_3216Metric_Pad1.30x1.75mm_HandSolder
R8, R9: 100k; R_1206_3216Metric_Pad1.30x1.75mm_HandSolder
RS1, RS2: 100; R_1206_3216Metric_Pad1.30x1.75mm_HandSolder
RX1: SMA; SMA_Samtec_SMA-J-P-H-ST-EM1_EdgeMount
TX1: SMA; SMA_Samtec_SMA-J-P-H-ST-EM1_EdgeMount
U1: SI5351Module; SI5351 Module
U2: SN74CB3T3253; SOIC-16_4.55x10.3mm_P1.27mm
U3: AMS1117-5.0; SOT-223-3_TabPin2
U5: AMS1117-3.3; SOT-223-3_TabPin2
U6: LT6231; SO-8_3.9x4.9mm_P1.27mm

Connections:
+3.3V: C14.1, C15.1, C17.2, D5.1 (K), U1.1 (VIN), U5.2 (VO)
+5V: C3.1, C13.1, C16.2, D4.1 (K), R2.1, U2.16 (VCC), U3.2 (VO), U5.3 (VI), U6.8 (V+)
+12V: C8.1, D1.1 (K), U3.3 (VI)
GND: C2.2, C3.2, C4.1, C5.1, C6.1, C7.1, C8.2, C13.2, C14.2, C15.2, C16.1, C17.1, D2.2 (A), D3.1 (K), D4.2 (A), D5.2 (A), H1.1, H2.1, H3.1, H4.1, J1.3, J2.2, J3.2, R3.2, RX1.2 (Ext), TX1.2 (Ext), U1.2 (GND), U2.1 (1~OE), U2.8 (GND), U2.15 (2~OE), U3.1 (GND), U5.1 (GND), U6.4 (V-)
unnamed: C2.1, L1.1, R2.2, R3.1
unnamed: C11.2, R8.2, RS1.1, U6.7
unnamed: C12.2, R9.2, RS2.2, U6.1
unnamed: CC1.2, RS1.2
unnamed: CC2.1, RS2.1
unnamed: CD1.1, R4.2
unnamed: CD2.1, R6.2
unnamed: D1.2 (A), F1.2
unnamed: C1.2, D2.1 (K), D3.2 (A), RX1.1 (In)
unnamed: J1.1, U1.4 (SCL)
unnamed: J1.2, U1.3 (SDA)
unnamed: F1.1, J2.1
unnamed: CC2.2, J3.1
unnamed: CC1.1, J3.3
unnamed: TX1.1 (In), U1.5 (S2)
unnamed: U1.6 (S1), U2.2 (S1)
unnamed: U1.7 (SO), U2.14 (S0)
unnamed: C1.1, L1.2, U2.9 (2A)
unnamed: C5.2, CD2.2, U2.10 (2B1)
unnamed: C6.2, R5.2, U2.11 (2B2)
unnamed: C4.2, CD1.2, U2.12 (2B3)
unnamed: C7.2, R7.2, U2.13 (2B4)
unnamed: R7.1, U6.3 (+)
unnamed: C12.1, R6.1, R9.1, U6.2 (-)
unnamed: R5.1, U6.5 (+)
unnamed: C11.1, R4.1, R8.1, U6.6 (-)

Notes on the sheet:
truSDX: -q +I +q -I -q +I +q -I = anti-clockwise (I on X axis, Q on Y)
NPO
7v to 12v (lesser is better!)
DNP
0 (00)
180 (11)
BWdet = 1 / (math.pi * 4 * 50 * 22 * 10**-9) ~= 72.5 kHz
R, values determine gain 100k/100 = 1000x 20*log10(100k/100) = 60dB
Note: Try 100pF (~15 kHz BW) for receiving DRM!
Replace 22n MKP caps by 220nF / 470nF MKP caps to reduce the bandwidth.
90 (01)
270 (10)
R, C values determine LPF cutoff 1/(2 * math.pi * 470e-9 * 100) ~= 3.3kHz
Si5351 with TCXO 3.3v ONLY
Single Balanced Configuration
This follows the truSDX configuration. S0/S1 order is 0, 1, 3, 2 aka 00, 01, 11, 10.

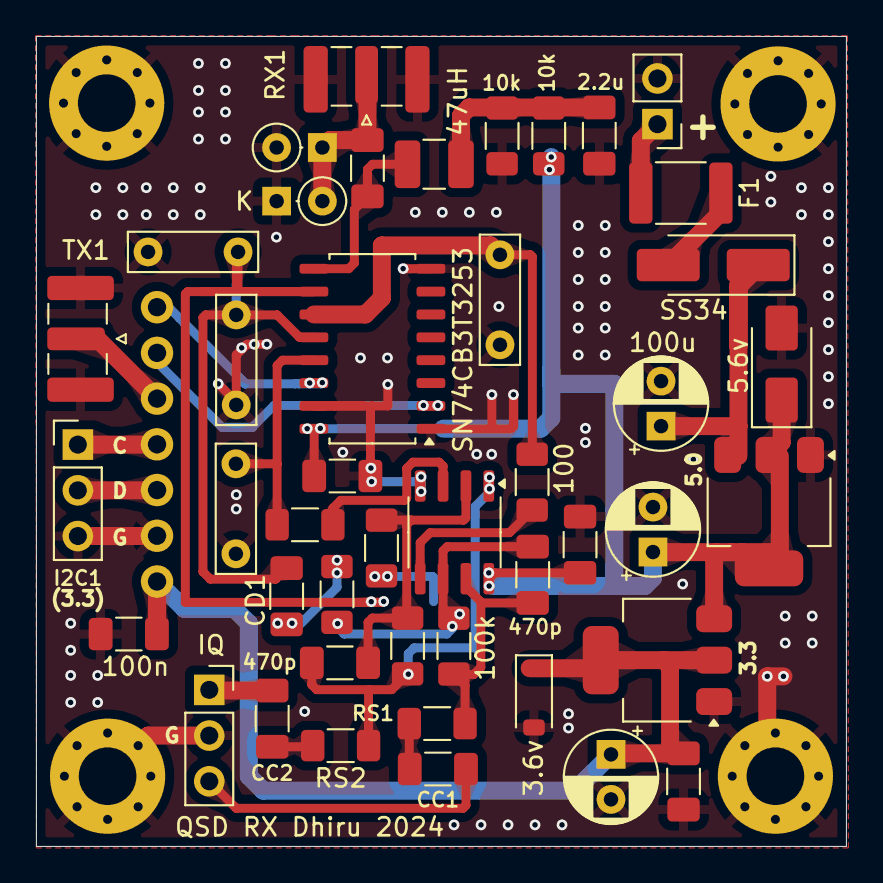
[picture p64: board SDR-Board.kicad_pcb from above]

Board: 2 copper layers, 45.0 x 45.0 mm, 50 parts (1 on the bottom side), 30 nets.
